makerhqsac/tentris/README.md

# tentris - Ten foot tall tetris game made from a boatload of neopixels
