makerhqsac/tentris/images/fullstructure.png

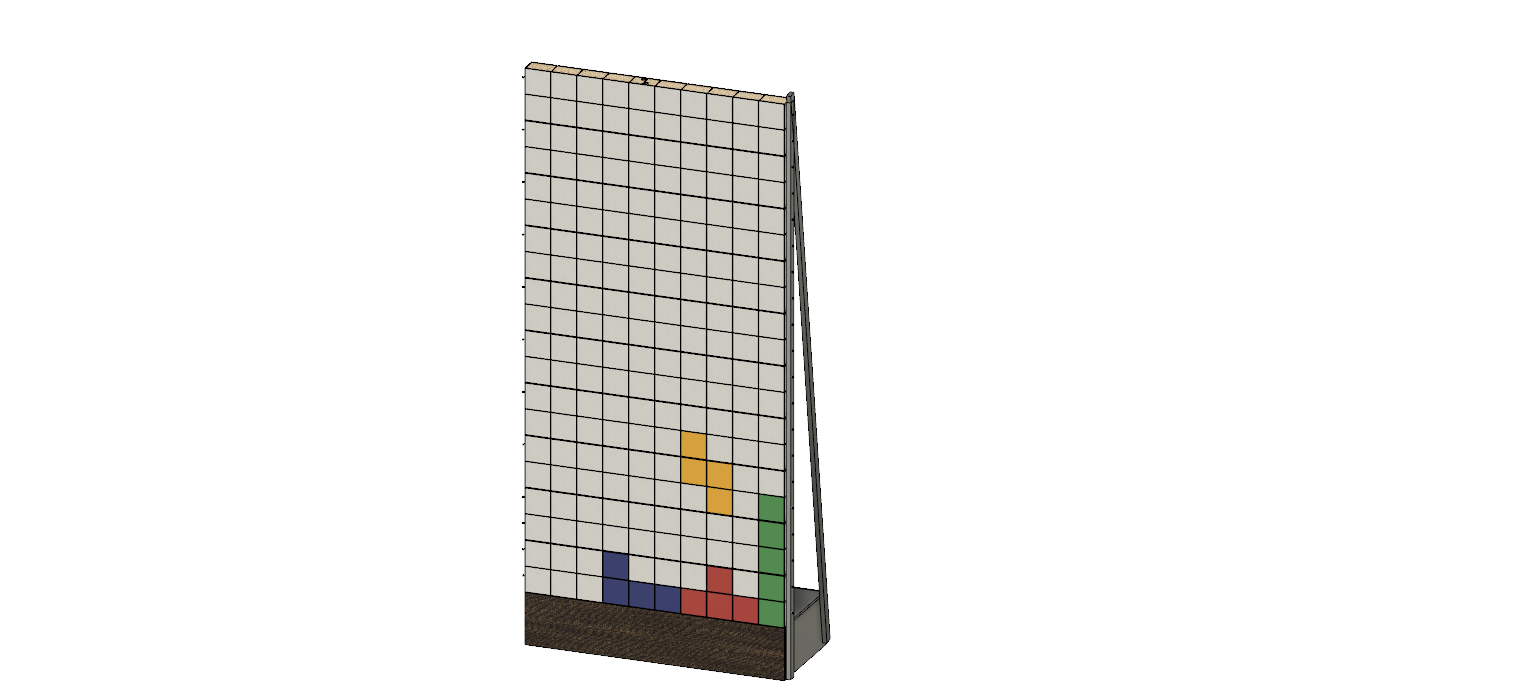
images/fullstructure.png
