makerhqsac/tentris/images/single_pod.png

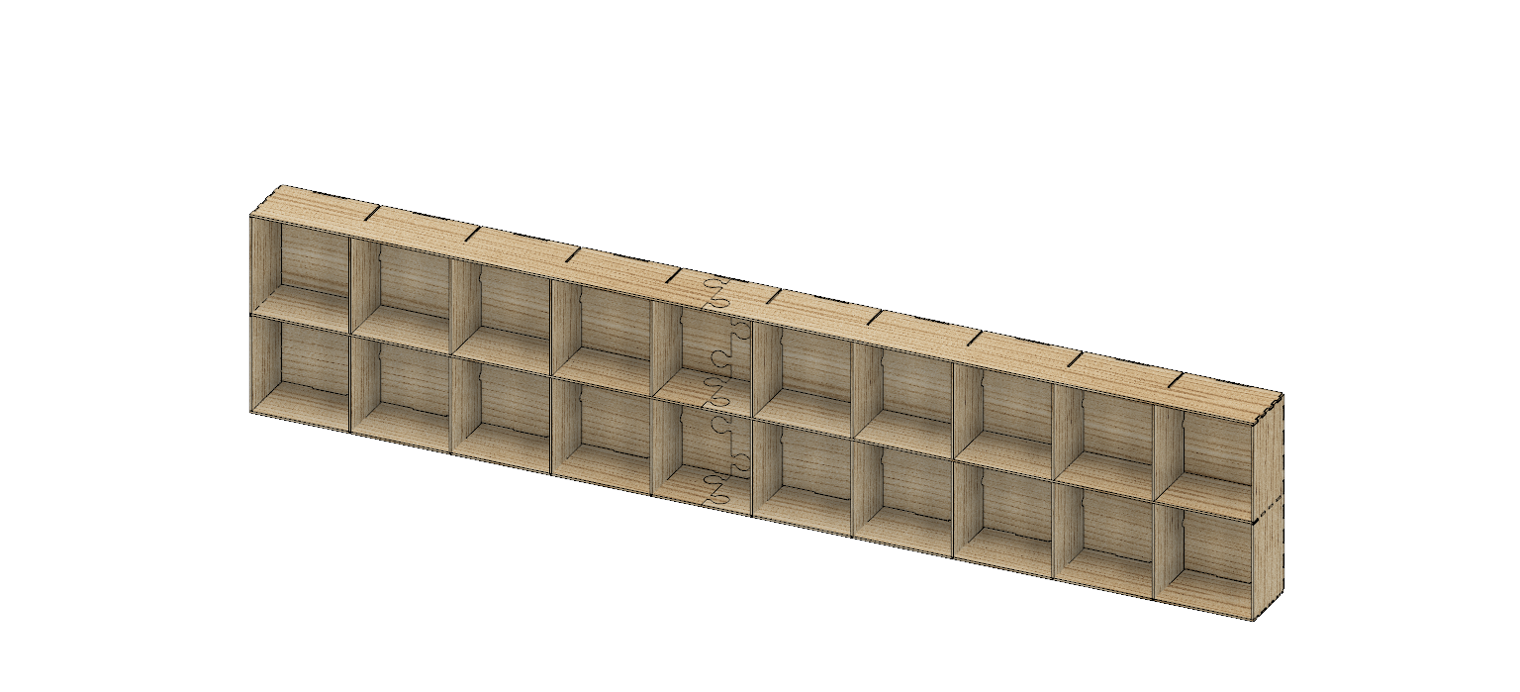
images/single_pod.png
