makerhqsac/tentris/mechanical/Plug.dxf

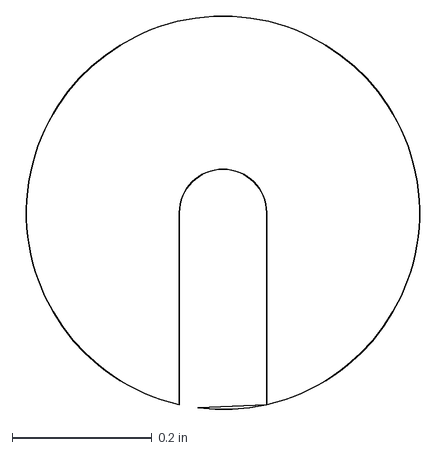
[picture p3: CAD file, 2017-09-19]
mechanical/Plug.dxf
0.591 x 0.564 in
