makerhqsac/tentris/mechanical/End.dxf

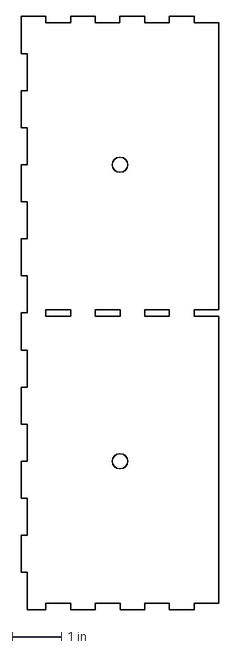
[picture p4: CAD file, 2017-09-19]
mechanical/End.dxf
4.00 x 12.0 in
