makerhqsac/tentris/mechanical/RightMiddle.dxf

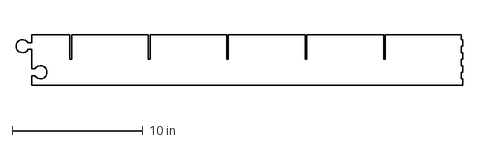
[picture p5: CAD file, 2017-09-19]
mechanical/RightMiddle.dxf
34.2 x 3.88 in
