makerhqsac/tentris/mechanical/LeftTop&Bottom.dxf

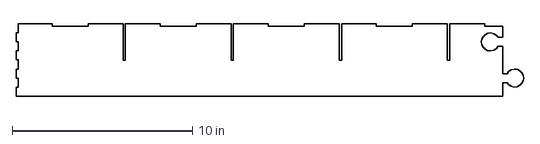
[picture p6: CAD file, 2017-09-19]
mechanical/LeftTop&Bottom.dxf
28.2 x 4.00 in
