makerhqsac/tentris/mechanical/LeftBack.dxf

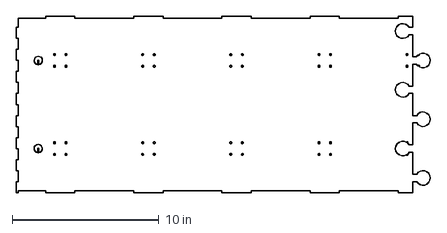
[picture p7: CAD file, 2017-09-19]
mechanical/LeftBack.dxf
28.2 x 12.0 in
