makerhqsac/tentris/mechanical/RightTop&Bottom.dxf

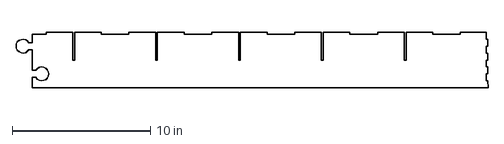
[picture p8: CAD file, 2017-09-19]
mechanical/RightTop&Bottom.dxf
34.2 x 4.00 in
