makerhqsac/tentris/mechanical/LeftMiddle.dxf

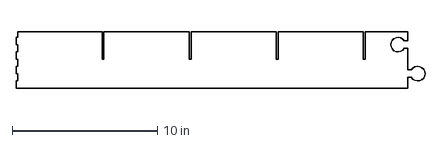
[picture p9: CAD file, 2017-09-19]
mechanical/LeftMiddle.dxf
28.2 x 3.88 in
