makerhqsac/tentris/mechanical/RightBack.dxf

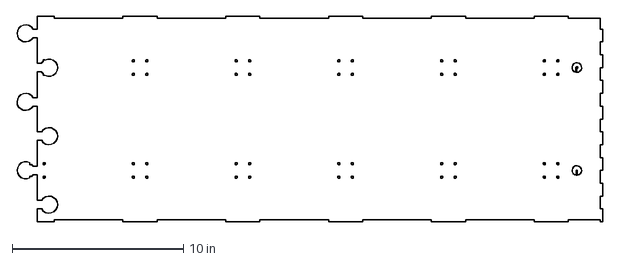
[picture p10: CAD file, 2017-09-19]
mechanical/RightBack.dxf
34.2 x 12.0 in
