makerhqsac/tentris/mechanical/Slat.dxf

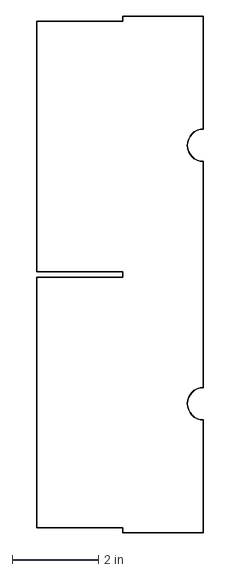
[picture p11: CAD file, 2017-09-19]
mechanical/Slat.dxf
3.87 x 12.0 in
