makerhqsac/tentris/hardware/tentris_controller/tentris_controller_v1.pdf

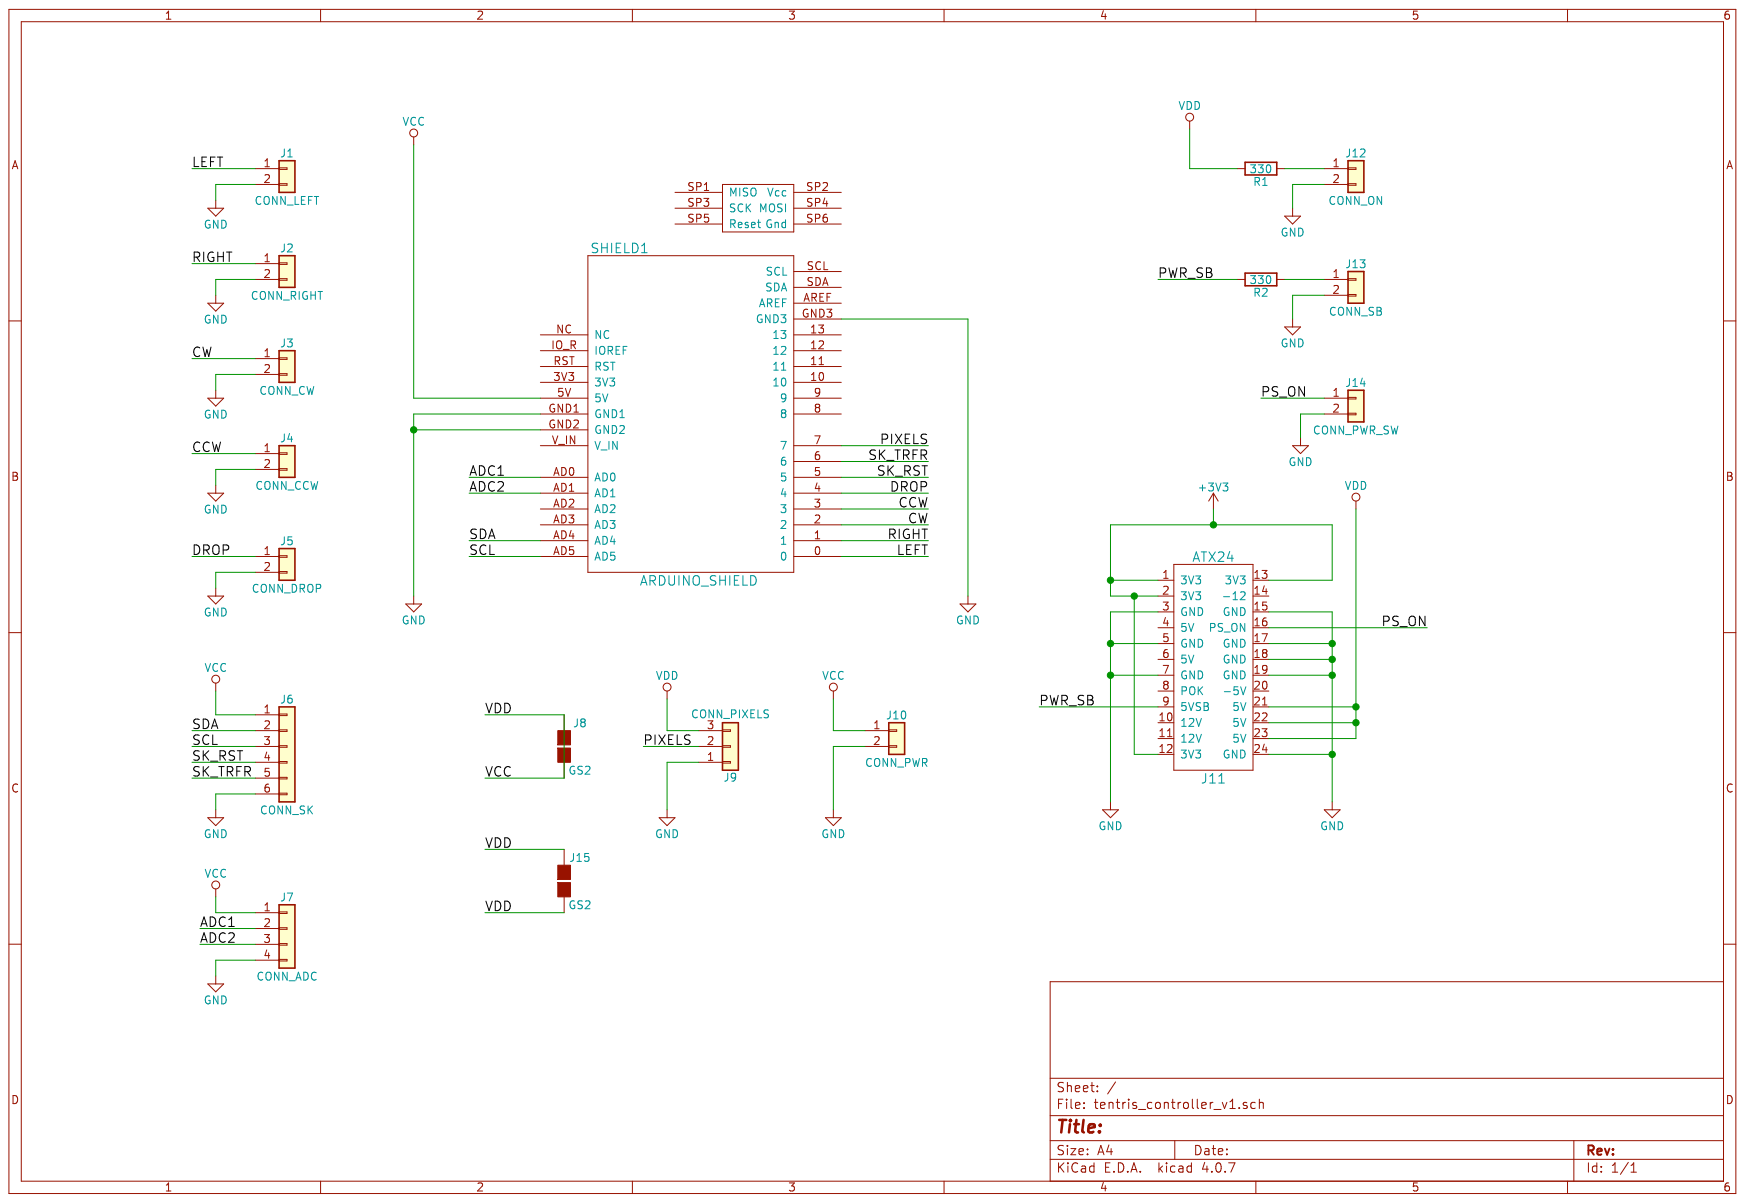
[picture p12: page 1]
