makerhqsac/tentris/hardware/megapixel/quad-neopixel-module.kicad_pcb

## KiCad design hardware/megapixel/quad-neopixel-module.kicad_pcb (2017-09-20)

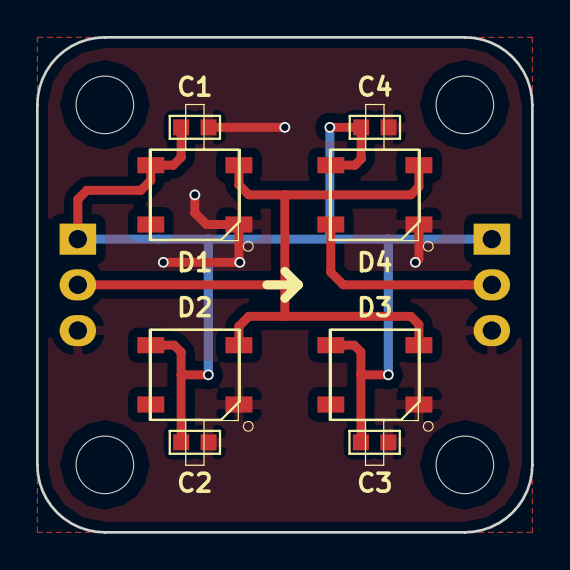
[picture p13: board quad-neopixel-module.kicad_pcb from above]

Board: 2 copper layers, 27.5 x 27.5 mm, 10 parts (0 on the bottom side), 4 nets.

Parts:
C1, C2, C3, C4: CERAMIC-100NF-50V-10%-X7R_0603_; C0603
D1, D2, D3, D4: SMD-RGB-LED-4P; LED4-SMD-5050
P1, P2: CONN_01X03; Pin_Header_Straight_1x03

Connections:
DIN: D1.4, D2.4, D3.4, D4.4, P1.2
DOUT: D4.2, P2.2
GND: C1.2, C2.2, C3.2, C4.2, D1.3, D2.3, D3.3, D4.3, P1.3, P2.3
VCC: C1.1, C2.1, C3.1, C4.1, D1.1, D2.1, D3.1, D4.1, P1.1, P2.1
