makerhqsac/tentris/hardware/tentris_controller/tentris_controller_v1.kicad_pcb

## KiCad design hardware/tentris_controller/tentris_controller_v1.kicad_pcb (2017-09-18)

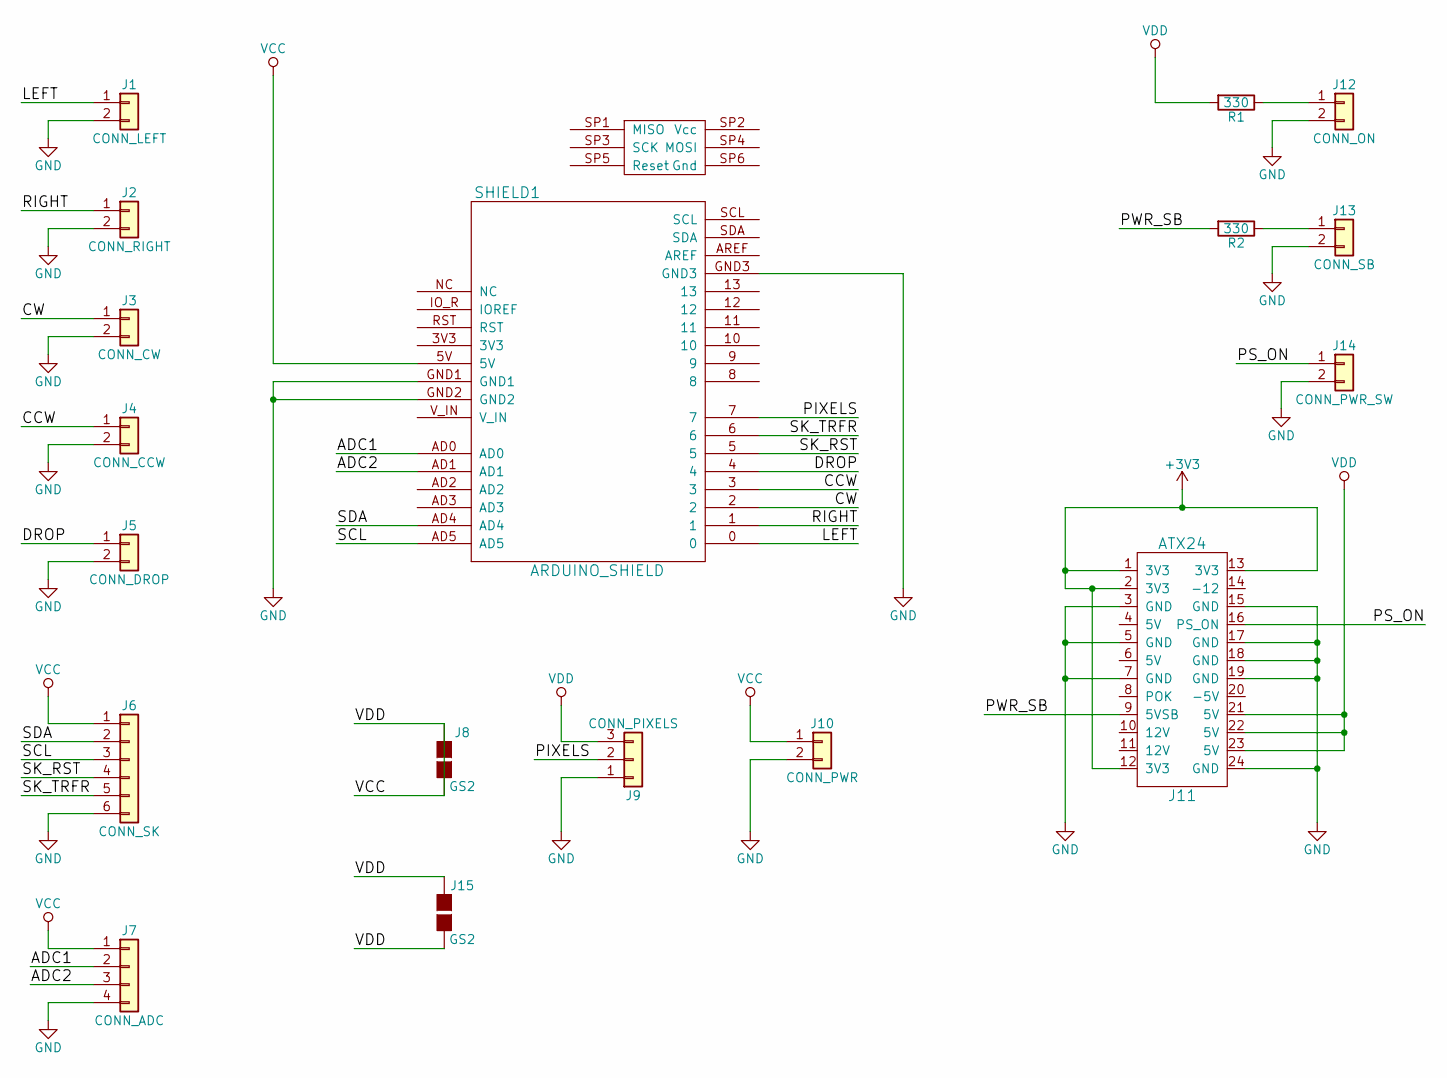
[picture p14: schematic tentris_controller_v1.sch]

Parts:
J1: CONN_LEFT; TerminalBlock_Pheonix_PT-3.5mm_2pol
J2: CONN_RIGHT; TerminalBlock_Pheonix_PT-3.5mm_2pol
J3: CONN_CW; TerminalBlock_Pheonix_PT-3.5mm_2pol
J4: CONN_CCW; TerminalBlock_Pheonix_PT-3.5mm_2pol
J5: CONN_DROP; TerminalBlock_Pheonix_PT-3.5mm_2pol
J6: CONN_SK; TerminalBlock_Pheonix_PT-3.5mm_6pol
J7: CONN_ADC; TerminalBlock_Pheonix_PT-3.5mm_4pol
J8: GS2
J9: CONN_PIXELS; TerminalBlock_Pheonix_PT-3.5mm_3pol
J10: CONN_PWR; TerminalBlock_Pheonix_PT-3.5mm_2pol
J11: ATX24; Molex_MiniFit-JR-5569-24A2_2x12x4.20mm_Angled
J12: CONN_ON; TerminalBlock_Pheonix_PT-3.5mm_2pol
J13: CONN_SB; TerminalBlock_Pheonix_PT-3.5mm_2pol
J14: CONN_PWR_SW; TerminalBlock_Pheonix_PT-3.5mm_2pol
J15: GS2; WireConnection_2.50mmDrill_LargePad
R1, R2: 330; R_Axial_DIN0204_L3.6mm_D1.6mm_P5.08mm_Horizontal
SHIELD1: ARDUINO_SHIELD

Connections:
+3V3: J11.1 (3V3), J11.2 (3V3), J11.12 (3V3), J11.13 (3V3)
/ADC1: J7.2, SHIELD1.AD0
/ADC2: J7.3, SHIELD1.AD1
/CCW: J4.1, SHIELD1.3
/CW: J3.1, SHIELD1.2
/DROP: J5.1, SHIELD1.4
/LEFT: J1.1, SHIELD1.0
/PIXELS: J9.2, SHIELD1.7
/PS_ON: J11.16 (PS_ON), J14.1
/PWR_SB: J11.9 (5VSB), R2.2
/RIGHT: J2.1, SHIELD1.1
/SCL: J6.3, SHIELD1.AD5
/SDA: J6.2, SHIELD1.AD4
/SK_RST: J6.4, SHIELD1.5
/SK_TRFR: J6.5, SHIELD1.6
GND: J1.2, J2.2, J3.2, J4.2, J5.2, J6.6, J7.4, J9.1, J10.2, J11.3 (GND), J11.5 (GND), J11.7 (GND), J11.15 (GND), J11.17 (GND), J11.18 (GND), J11.19 (GND), J11.24 (GND), J12.2, J13.2, J14.2, SHIELD1.GND1, SHIELD1.GND2, SHIELD1.GND3
unnamed: J12.1, R1.1
unnamed: J13.1, R2.1
VCC: J6.1, J7.1, J8.1 (G1), J8.2 (G2), J9.3, J10.1, J11.21 (5V), J11.22 (5V), J11.23 (5V), J15.1 (G1), J15.2 (G2), R1.2, SHIELD1.5V

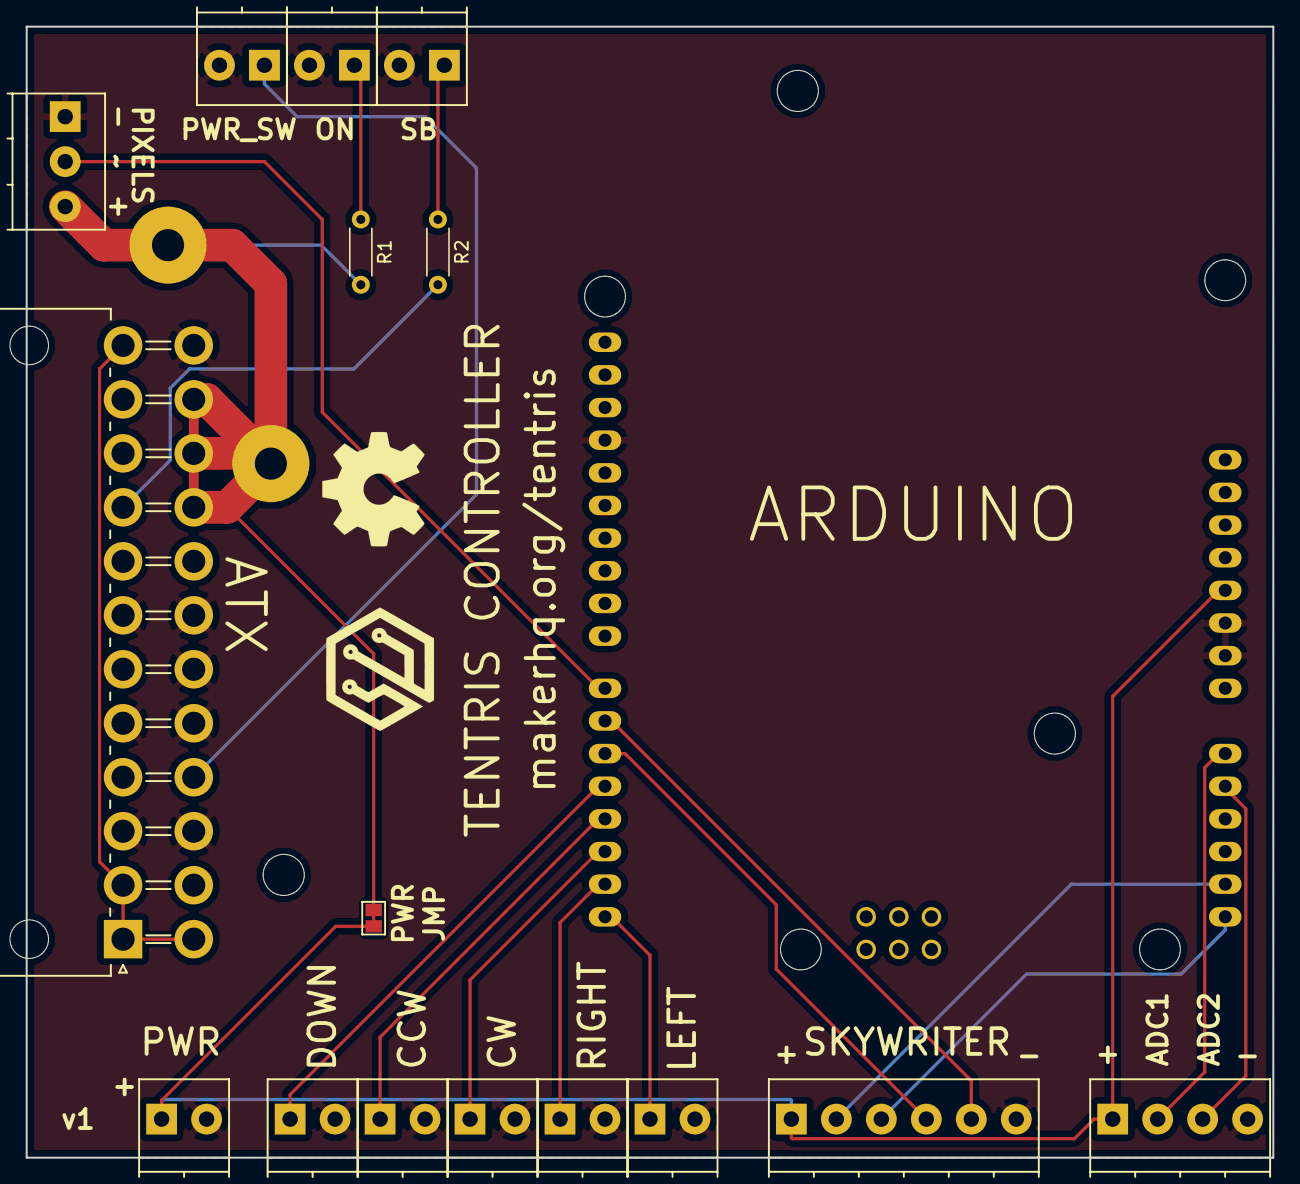
[picture p15: board tentris_controller_v1.kicad_pcb from above]

Board: 2 copper layers, 97.0 x 88.0 mm, 18 parts (1 on the bottom side), 19 nets.
