makerhqsac/tentris/(commit log)

2017-09-18 Initial commit of reorg repo
    [tentris_controller_v1.kicad_pcb, tentris_controller_v1.sch]
2017-09-18 Create Mechanical
    Files needed to laser cut the body.
2017-09-19 add mechanical
    [End.dxf, LeftBack.dxf, LeftMiddle.dxf, LeftTop&Bottom.dxf, Plug.dxf, RightBack.dxf, RightMiddle.dxf, RightTop&Bottom.dxf]
2017-09-20 Add megapixel kicad files
    [quad-neopixel-module.kicad_pcb, quad-neopixel-module.sch]
2017-09-22 Added another animation. Cleaned up overflow causing random pixels. Pulled everything into the configuration. Added delay after clearing board after user starts game.
2017-09-25 Clear out EEPROM on first startup. Chances are at least. Saving high score. Added basic rain animation start. Added reverse rotation. Fixed bug with rotate dropping a row.
    [config.h, shapes.h, tentris.ino]
2017-09-26 Add skywriter support. make config match tentris controller board.
2017-09-29 fix inputs, add paint
    [config.h, tenpaint.ino, tentris.ino]
2017-10-01 Fixed bugs in reverse rotate. Merged in Skywriter code. Added ability to gesture out of attract mode. Added bad hack to fix startup problem with Skywriter.
    [config.h, shapes.h, tentris.ino]
2017-10-07 Fixed rotate and merged sky and button
    [config.h, tentris.ino]
2017-10-13 Fixed memory issues
    Removed grid and used the NeoPixel library's internal storage for all lookups.
    [config.h, shapes.h, tentris.ino]
2017-10-14 Added scoring. Fixed overflow
    [config.h, shapes.h, tentris.ino]
2017-10-15 hopefully fix skywriter connection issues
    [tentris.ino]
2017-10-15 support snake style pixel wiring
2017-11-04 Added inverse
    Added the inverse direction for bottom-up wiriing like we have on the big board
2018-05-06 Modify tester to better work with gameboard
    Change output pin to 7
    Change number of pixels to 200
    Change brightness to 25% (64)
2018-05-10 Boundary issues
    Accidentally was stepping out of the array on the A0 and A1 buttons.
    [config.h, tentris.ino]
2018-05-17 reset score to 0 on new game
    [tentris.ino]
